Landflier/LinHT-rfic/release/v.1.0.0/img/chip_top_white.png

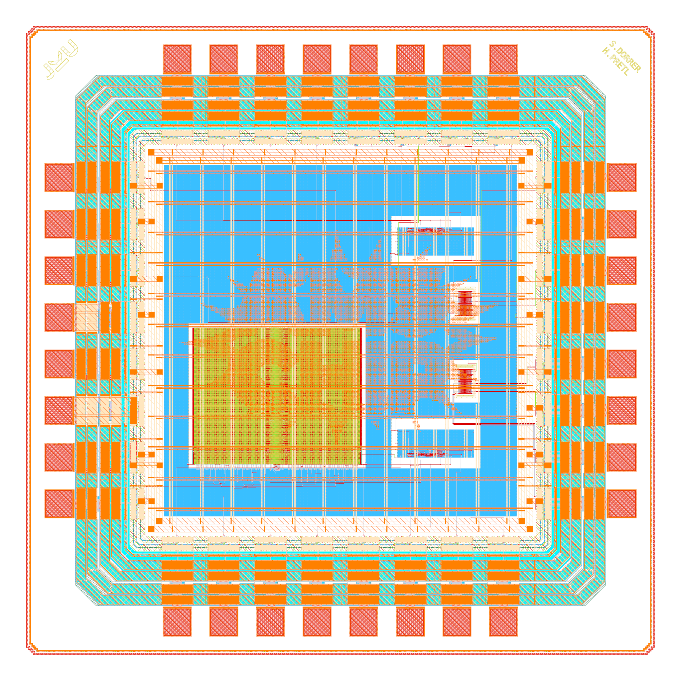
release/v.1.0.0/img/chip_top_white.png
