Landflier/LinHT-rfic/tutorial/fig/tools_overview/tools_overview.png

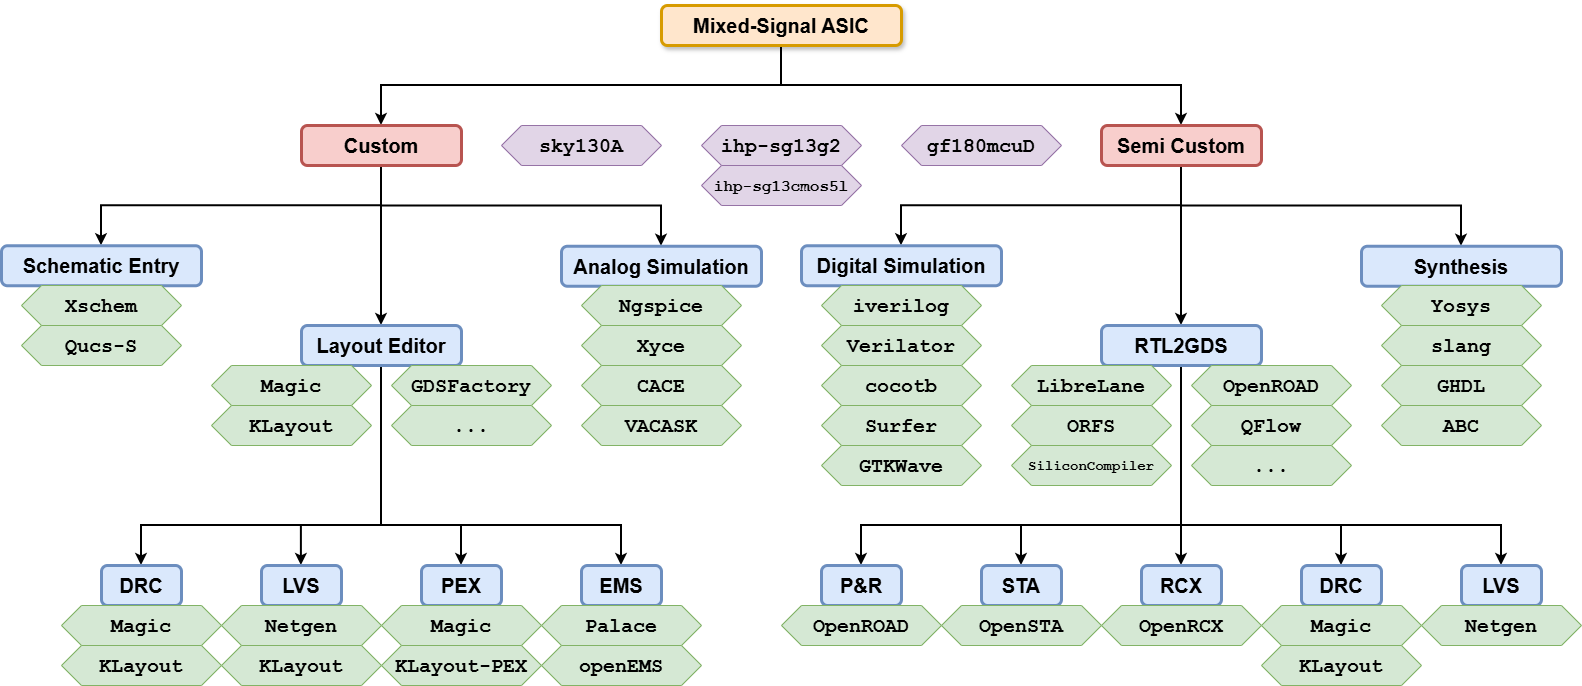
tutorial/fig/tools_overview/tools_overview.png
