Landflier/LinHT-rfic/tutorial/fig/chip_top/chip_top_black.png

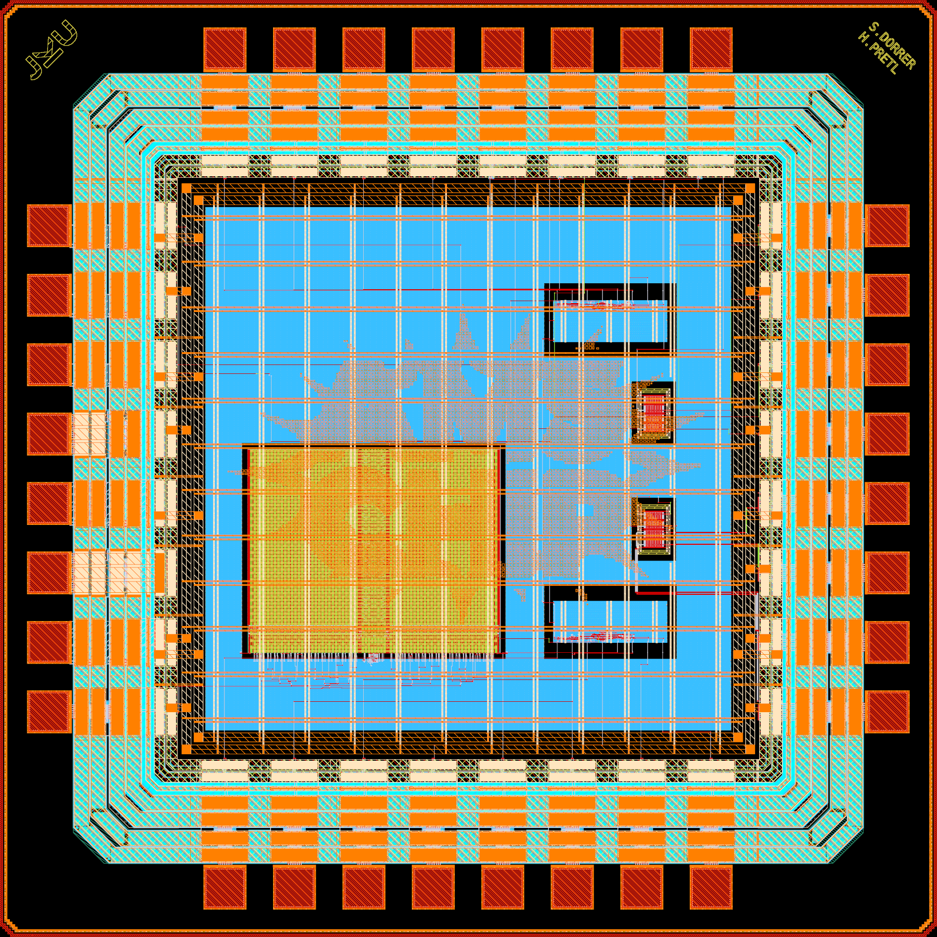
tutorial/fig/chip_top/chip_top_black.png
