Landflier/LinHT-rfic/tutorial/fig/chip_top/chip_top_black_TM2.png

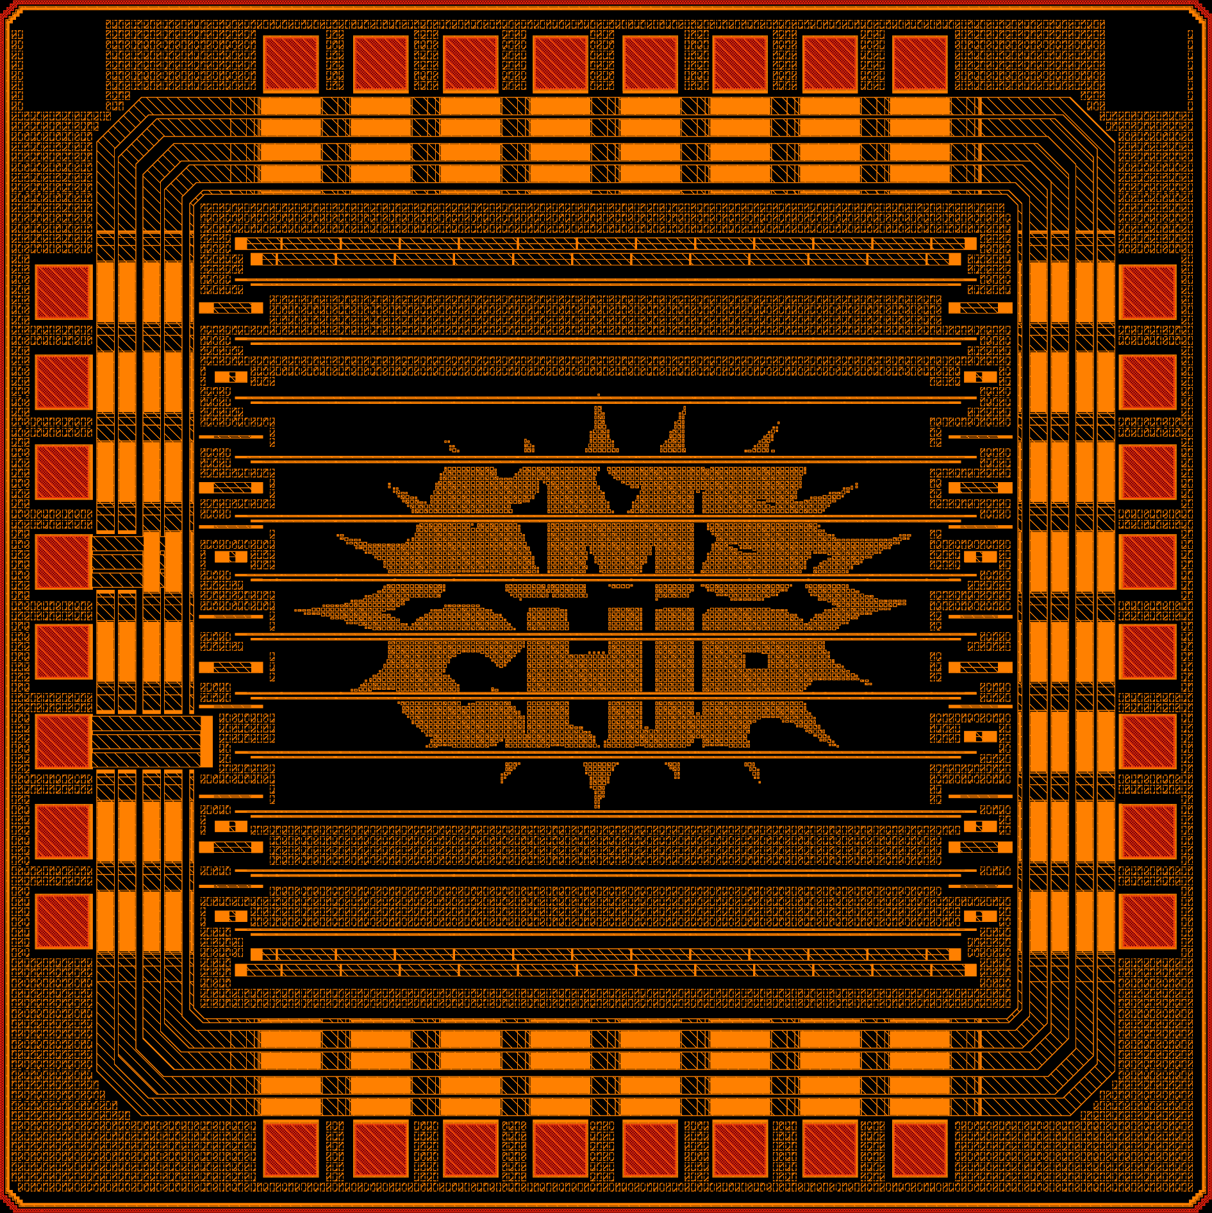
tutorial/fig/chip_top/chip_top_black_TM2.png
