Landflier/LinHT-rfic/tutorial/fig/chip_top/chip_top_cocotb_gtkwave.png

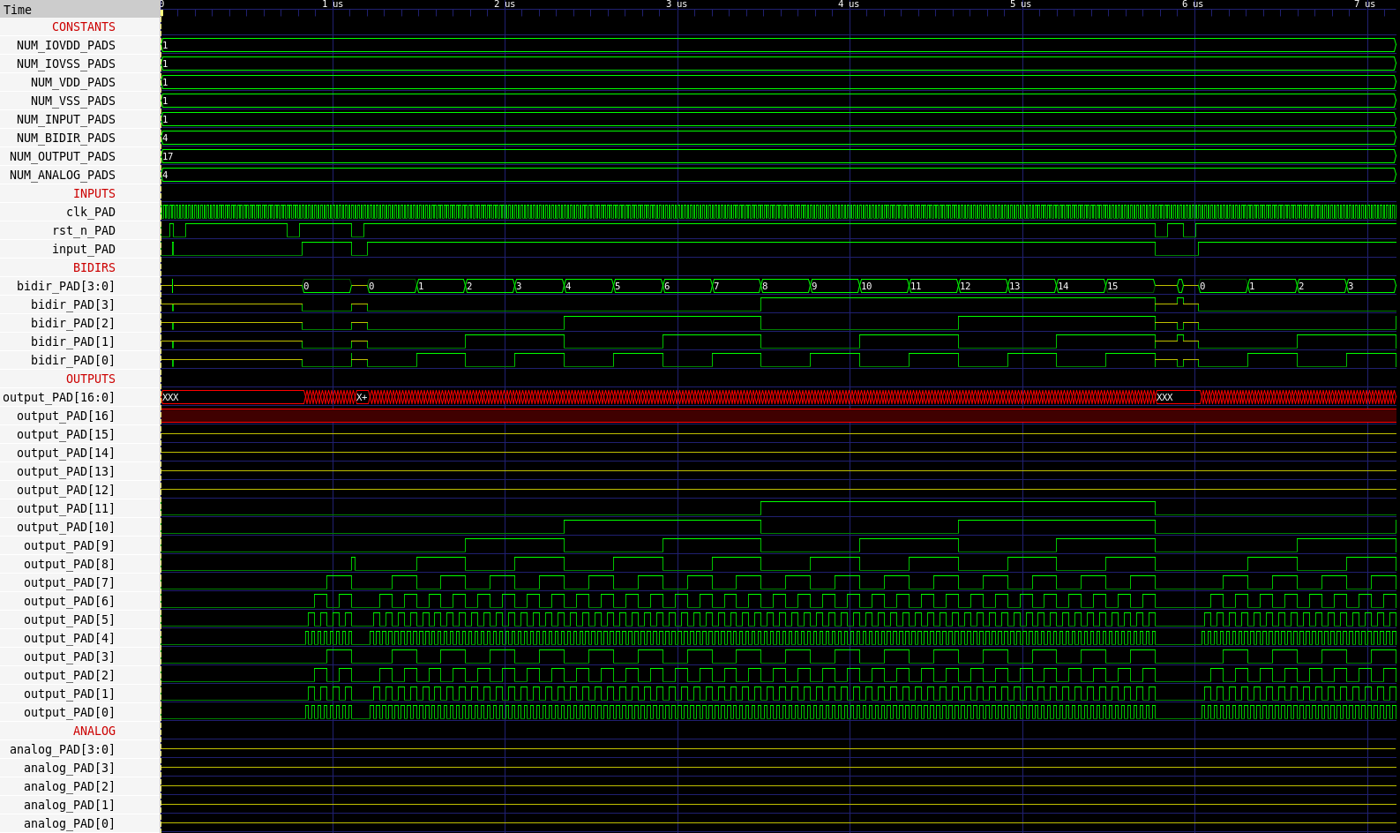
tutorial/fig/chip_top/chip_top_cocotb_gtkwave.png
