Landflier/LinHT-rfic/tutorial/fig/counter_top/counter_top_black.png

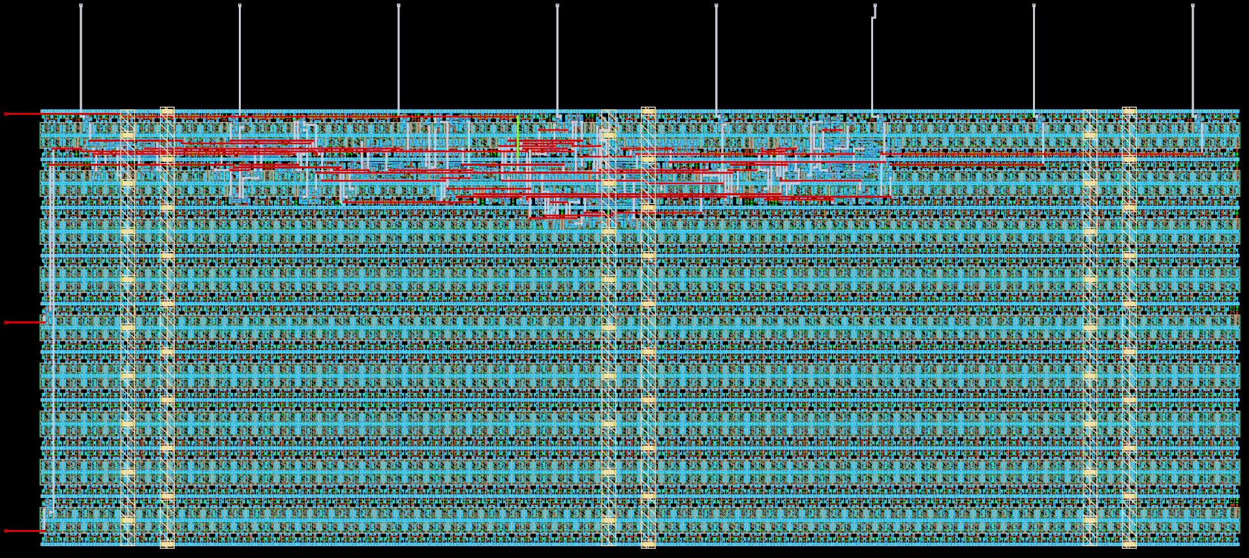
tutorial/fig/counter_top/counter_top_black.png
