Landflier/LinHT-rfic/tutorial/fig/counter_top/counter_top_cocotb_gtkwave.png

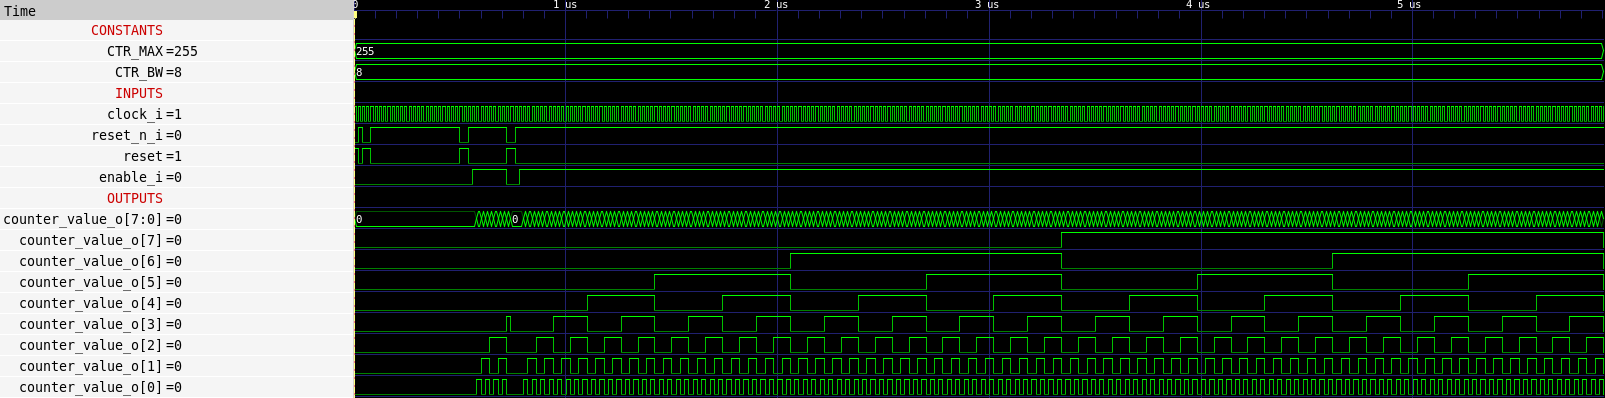
tutorial/fig/counter_top/counter_top_cocotb_gtkwave.png
