Landflier/LinHT-rfic/tutorial/fig/counter_top/counter_top_verilog_gtkwave.png

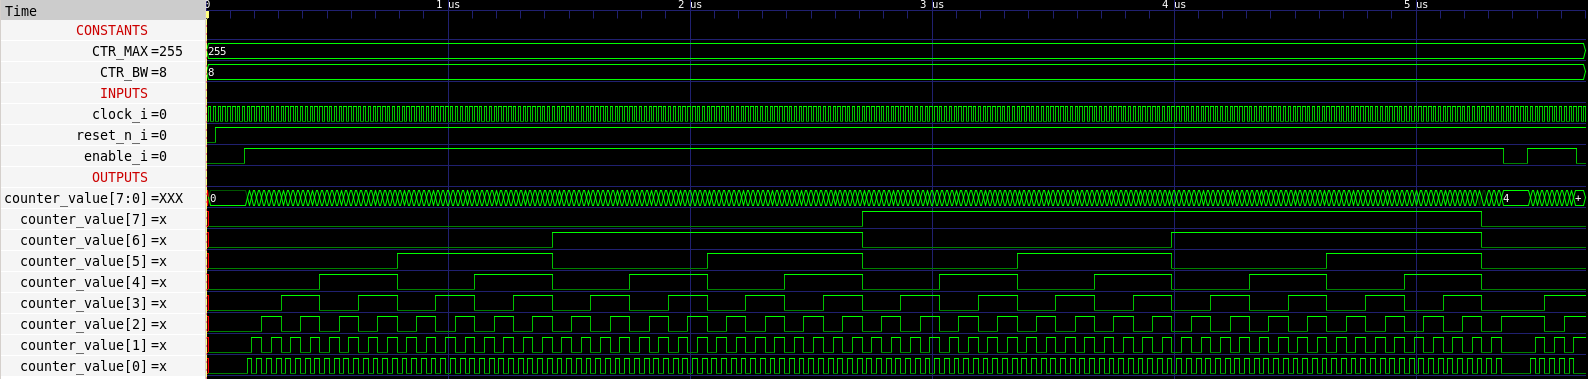
tutorial/fig/counter_top/counter_top_verilog_gtkwave.png
