Landflier/LinHT-rfic/tutorial/fig/inverter_top/Adc_ol_dB_mm.png

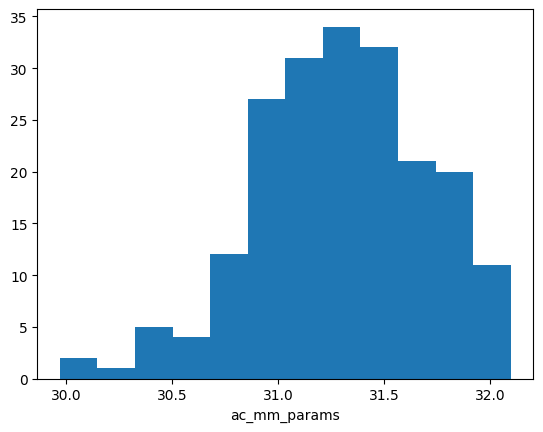
tutorial/fig/inverter_top/Adc_ol_dB_mm.png
