Landflier/LinHT-rfic/tutorial/fig/inverter_top/Adc_ol_dB_vs_vdd.png

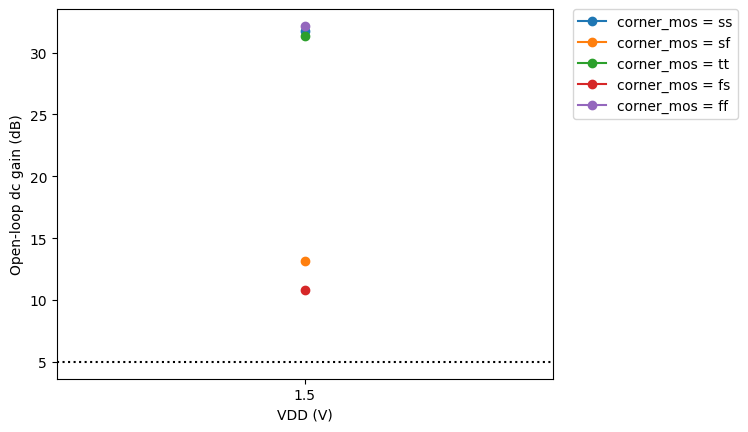
tutorial/fig/inverter_top/Adc_ol_dB_vs_vdd.png
