Landflier/LinHT-rfic/tutorial/fig/inverter_top/fcu_mc.png

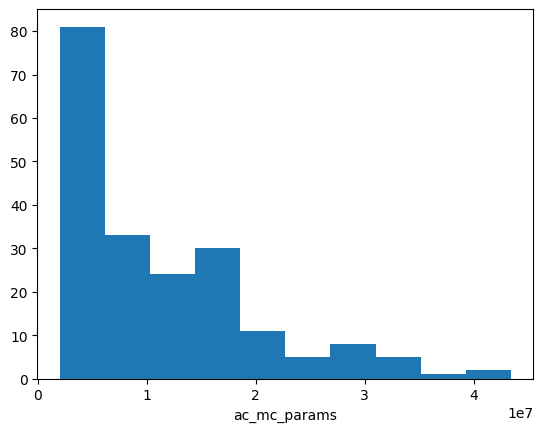
tutorial/fig/inverter_top/fcu_mc.png
