Landflier/LinHT-rfic/tutorial/fig/inverter_top/fcu_mm.png

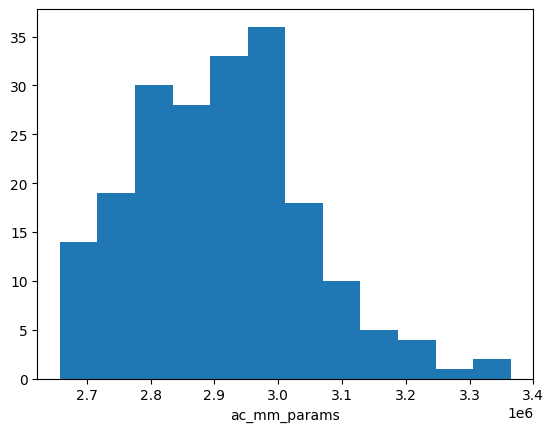
tutorial/fig/inverter_top/fcu_mm.png
