Landflier/LinHT-rfic/tutorial/fig/inverter_top/fcu_vs_vdd.png

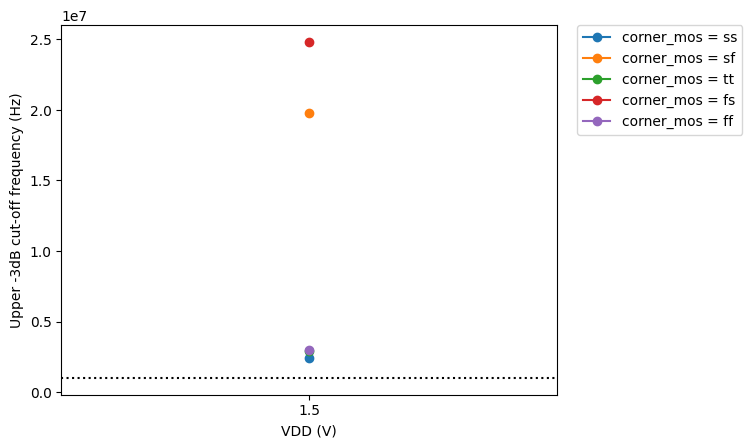
tutorial/fig/inverter_top/fcu_vs_vdd.png
