Landflier/LinHT-rfic/tutorial/fig/inverter_top/inverter_top_3D.png

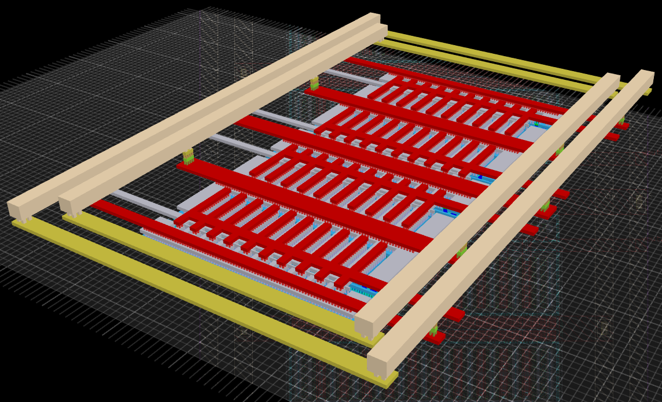
tutorial/fig/inverter_top/inverter_top_3D.png
