Landflier/LinHT-rfic/tutorial/fig/inverter_top/inverter_top_black.png

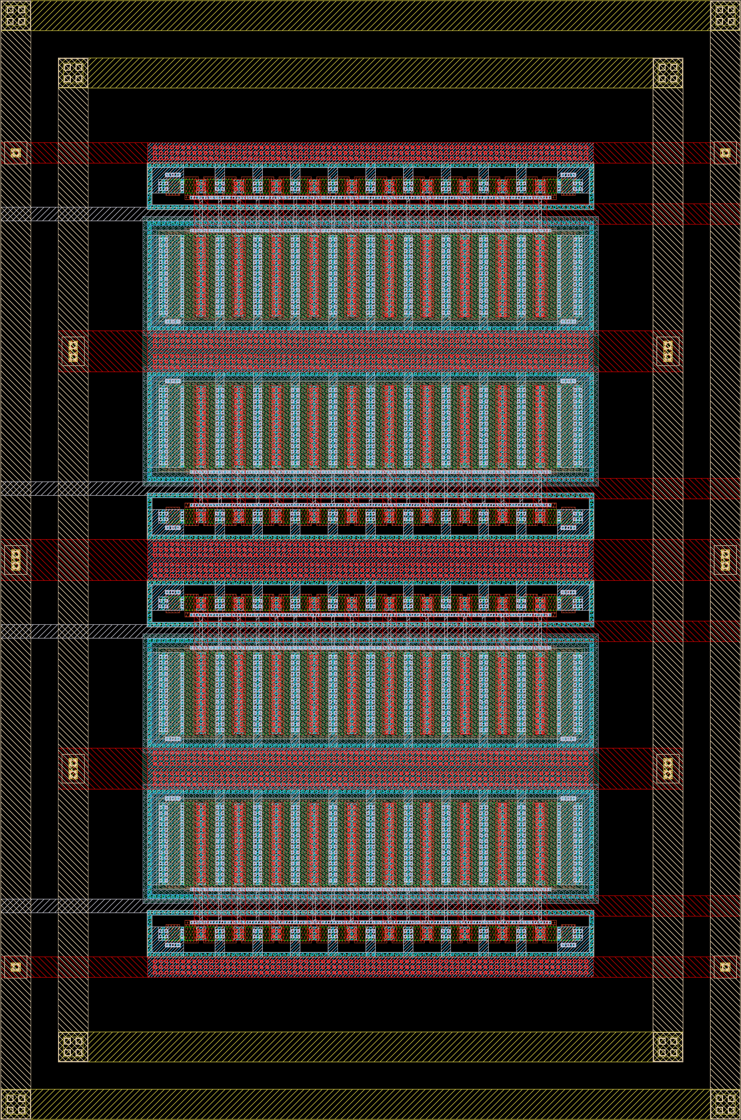
tutorial/fig/inverter_top/inverter_top_black.png
