Landflier/LinHT-rfic/tutorial/fig/inverter_top/KLayout_DRC_Output.png

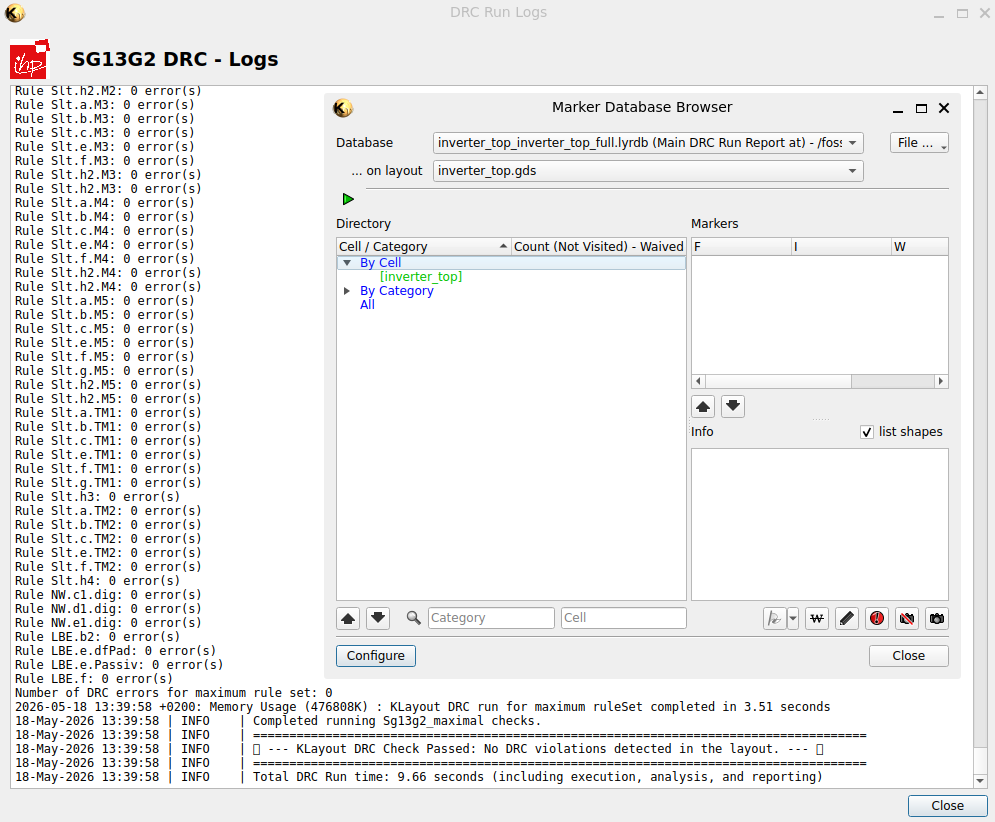
tutorial/fig/inverter_top/KLayout_DRC_Output.png
