Landflier/LinHT-rfic/tutorial/fig/inverter_top/KLayout_LVS_Output.png

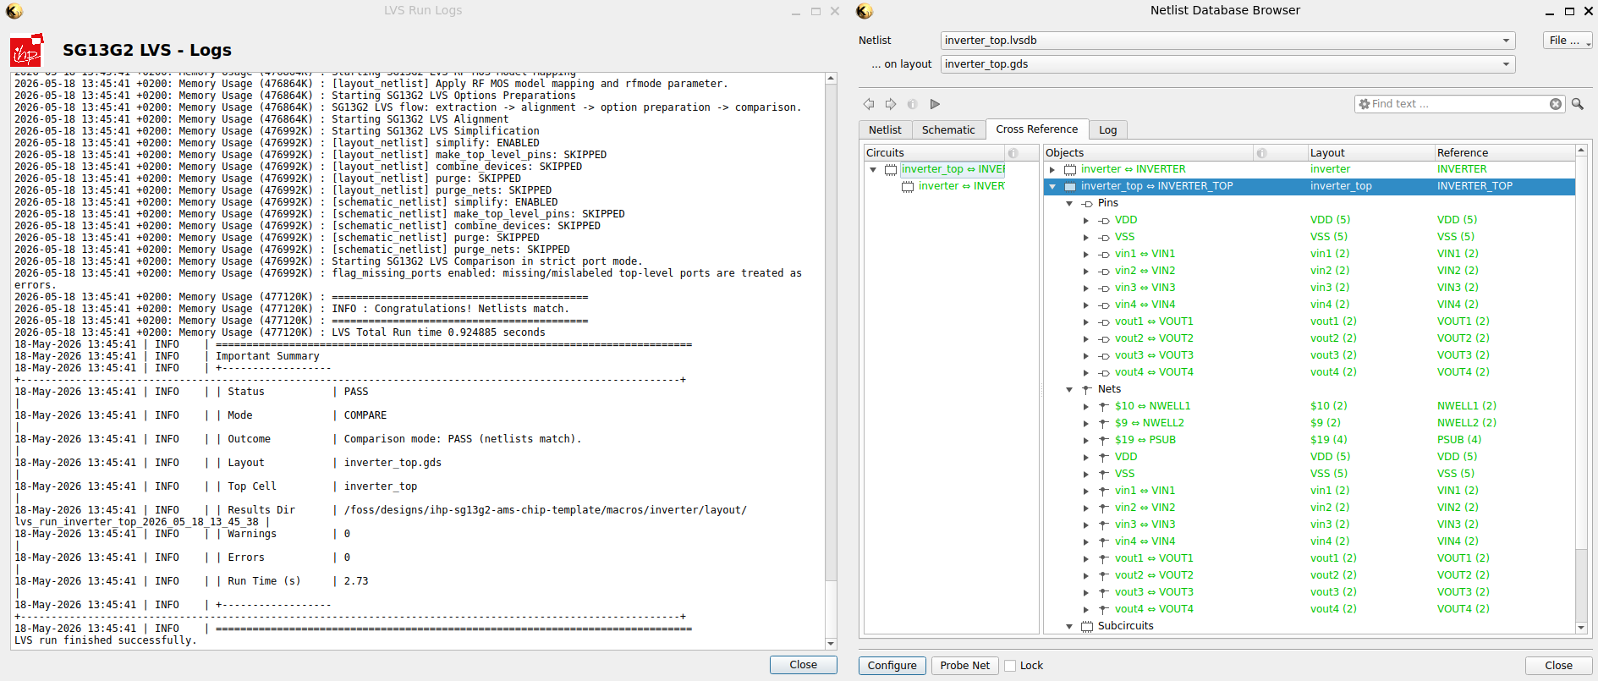
tutorial/fig/inverter_top/KLayout_LVS_Output.png
