Landflier/LinHT-rfic/tutorial/fig/targets_overview/targets_overview.pdf

# make all

make sim-all | make build-all

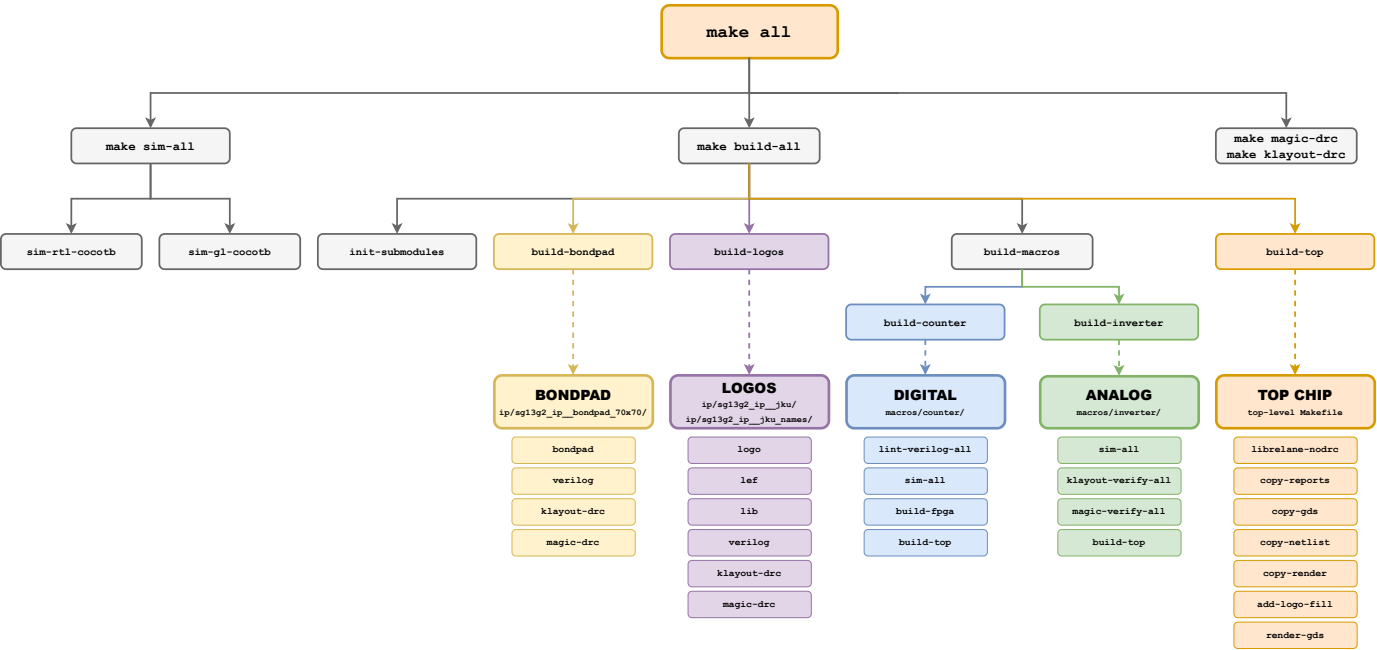
[picture p26: page 1]
sim-rtl-cocotb; sim-gl-cocotb; init-submodules; build-bondpad; build-logos; build-macros; build-top; build-counter; build-inverter; BONDPAD; ip/sg13g2_ip__bondpad_70x70/; LOGOS; ip/sg13g2_ip__jku/; ip/sg13g2_ip__jku_names/; DIGITAL; macros/counter/; ANALOG; macros/inverter/; TOP CHIP; bondpad; verilog; klayout-drc; magic-drc; logo; lef; lib; sim-all; build-fpga; librelane-nodrc; copy-reports; copy-gds; copy-netlist; copy-render; render-gds

make magic-drc
make klayout-drc

top-level Makefile

lint-verilog-all

klayout-verify-all

magic-verify-all

add-logo-fill
