Landflier/LinHT-rfic/(commit log)

2026-07-13 ADD: xschemrc for IIC-OSIC-TOOLS
    [template.sch]
2026-07-14 ADD: template files
    [pin_order.cfg]
2026-07-16 CRITICAL: empty folder for macros, only templates left over
    [counter_top_tb_tran.sch, inverter.sch, inverter_tb_ac.csv, inverter_tb_ac.sch, inverter_tb_ac_ol.csv, inverter_tb_ac_ol.sch, inverter_tb_dc_vout.csv, inverter_tb_dc_vout.sch]
2026-07-16 ADD: delta_sigma adc for tx chain
2026-07-19 MOVE: template schematic and xschemrc template file changed
    [template.sch]
2026-07-19 CRITICAL: removed the frame from the template, never appears in netlists
    [template.sch]
2026-07-23 CRITICAL: Script that ported the sg130cmos5l OSDI device models to VACASK models
2026-07-23 CRITICAL: changed the launcher symbols and the code symbols inside template.xch, so that the user can correctly select XYCE, ngspice or VACASK
    [template.sch]
2026-07-23 CRITICAL: change the code.sym to simulator_commands for the library intiation in the template.sch
    [template.sch]
2026-07-23 IGNORE: add verification, schematic, simulations
