Landflier/LinHT-rfic/(notices)

Notices in the files:
README.md:
License: Solderpad Hardware License v2.1
